icegoaliepaul/index/pnp/pcb/mobo/todo.txt

todo!

-decoupling on vacuum sensor stuff
