icegoaliepaul/index/pnp/cad/1.1.0/z-gantry-stepper-right.step

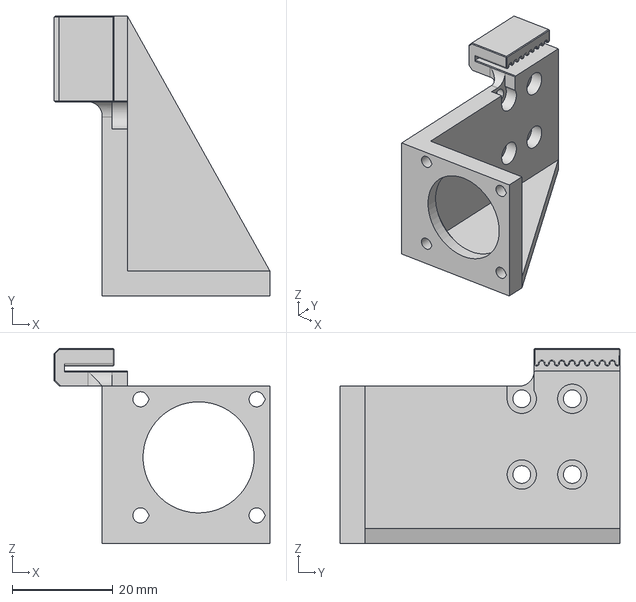
[picture p1: CAD file, 2020-12-14]
pnp/cad/1.1.0/z-gantry-stepper-right.step
42.7 x 55.5 x 38.7 mm
