icegoaliepaul/index/pnp/cad/1.1.0/STLs/y-gantry-right.stl

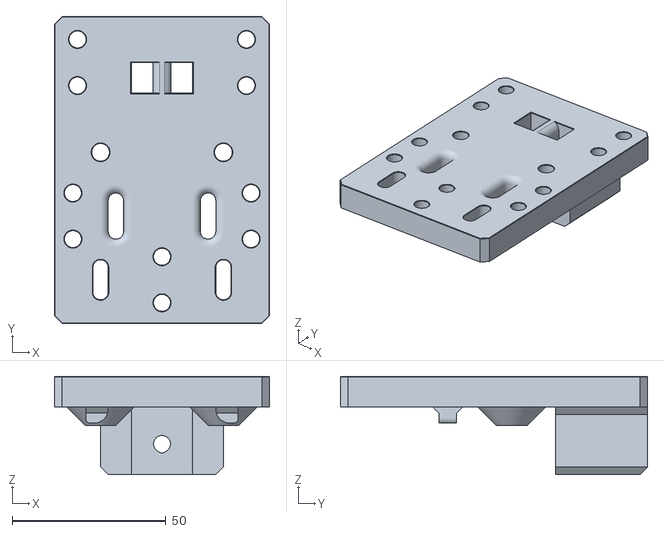
[picture p2: CAD file, 2020-11-08]
pnp/cad/1.1.0/STLs/y-gantry-right.stl
70.0 x 100.0 x 32.0
