icegoaliepaul/index/pnp/cad/1.1.0/z-gantry-stepper-left.step

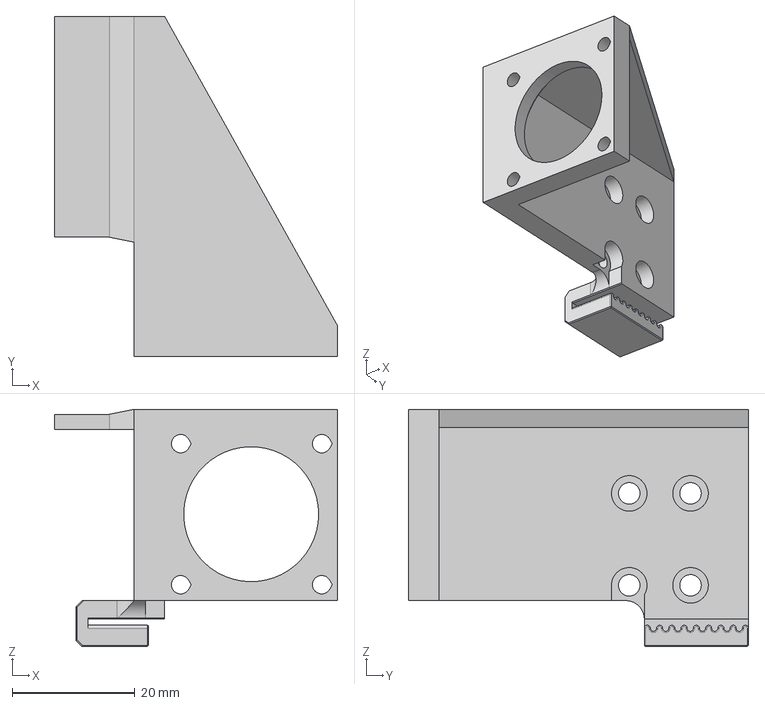
[picture p3: CAD file, 2020-12-14]
pnp/cad/1.1.0/z-gantry-stepper-left.step
46.2 x 55.5 x 38.7 mm
