icegoaliepaul/index/pnp/cad/1.1.0/x-limit-switch-actuator.step

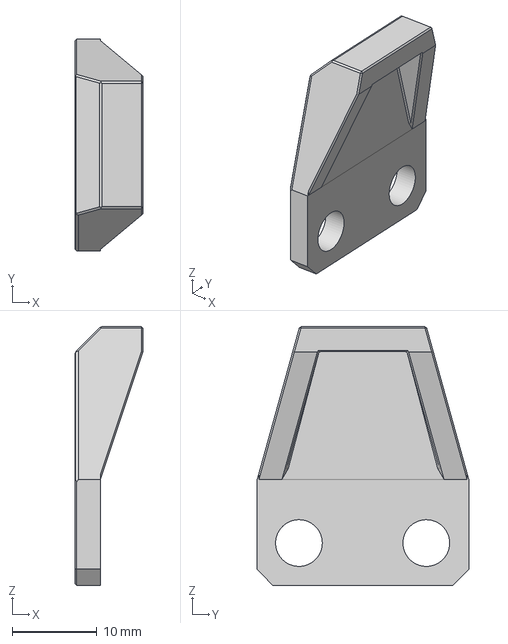
[picture p4: CAD file, 2020-11-16]
pnp/cad/1.1.0/x-limit-switch-actuator.step
8.00 x 24.9 x 30.5 mm
