icegoaliepaul/index/pnp/cad/1.1.0/Camera Holder.step

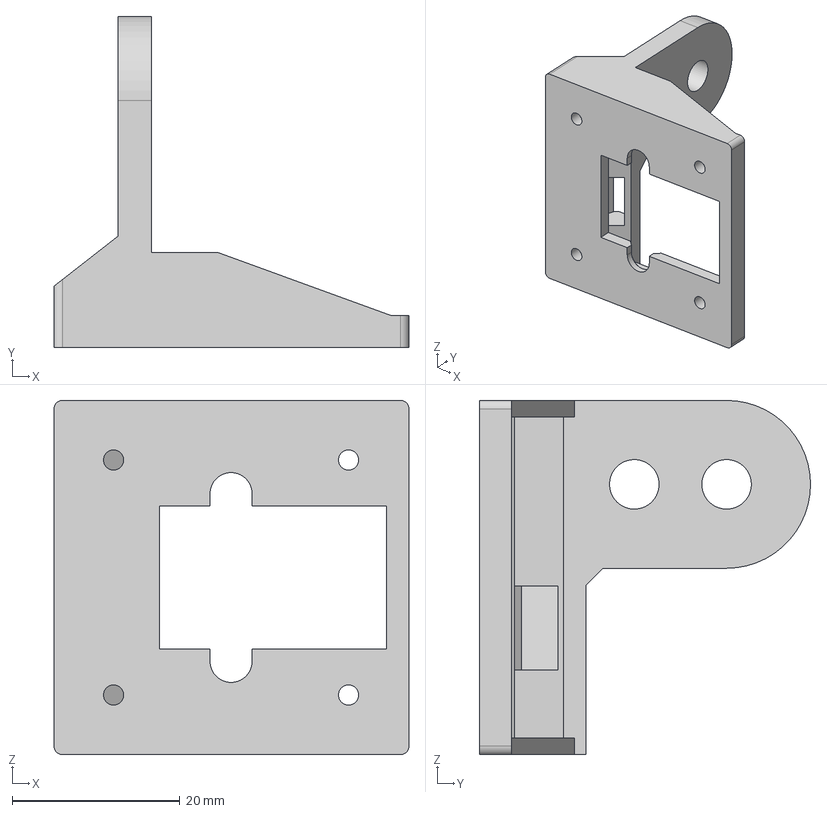
[picture p5: CAD file, 2020-11-13]
pnp/cad/1.1.0/Camera Holder.step
42.3 x 39.5 x 42.2 mm
