icegoaliepaul/index/pnp/cad/1.1.0/STLs/y-gantry-belt-standoff.stl

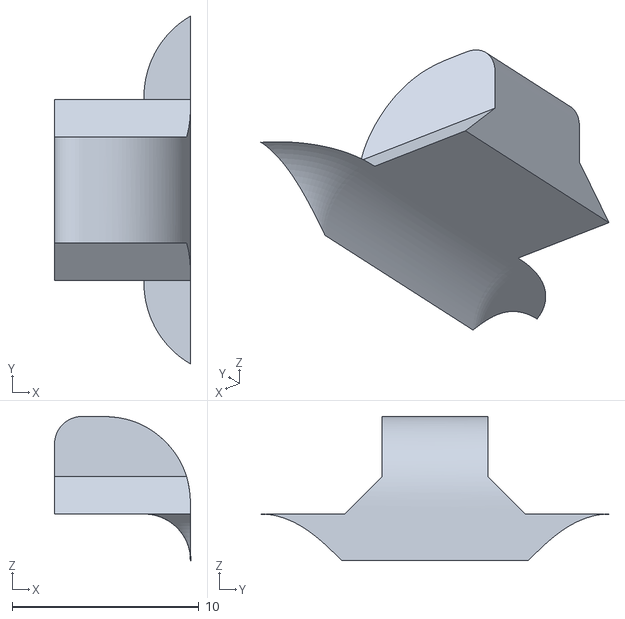
[picture p6: CAD file, 2020-11-08]
pnp/cad/1.1.0/STLs/y-gantry-belt-standoff.stl
7.30 x 18.7 x 7.74
