icegoaliepaul/index/(list of files, cad)

Other CAD files:
pnp/cad/1.1.0/STLs/y-gantry-left.stl
pnp/cad/1.1.0/Camera Holder.f3d
pnp/cad/1.1.0/STLs/Camera Holder.stl
pnp/cad/1.1.0/STLs/x-limit-switch-actuator.stl
pnp/cad/1.1.0/STLs/z-gantry-stepper-left.stl
pnp/cad/1.1.0/STLs/z-gantry-stepper-right.stl
pnp/cad/1.1.0/x-limit-switch-actuator.f3d
pnp/cad/1.1.0/z-gantry-stepper-left.f3d
pnp/cad/1.1.0/z-gantry-stepper-right.f3d
