icegoaliepaul/index/pnp/pcb/mobo/mobo.kicad_pcb

## KiCad design pnp/pcb/mobo/mobo.kicad_pcb (2020-12-23)

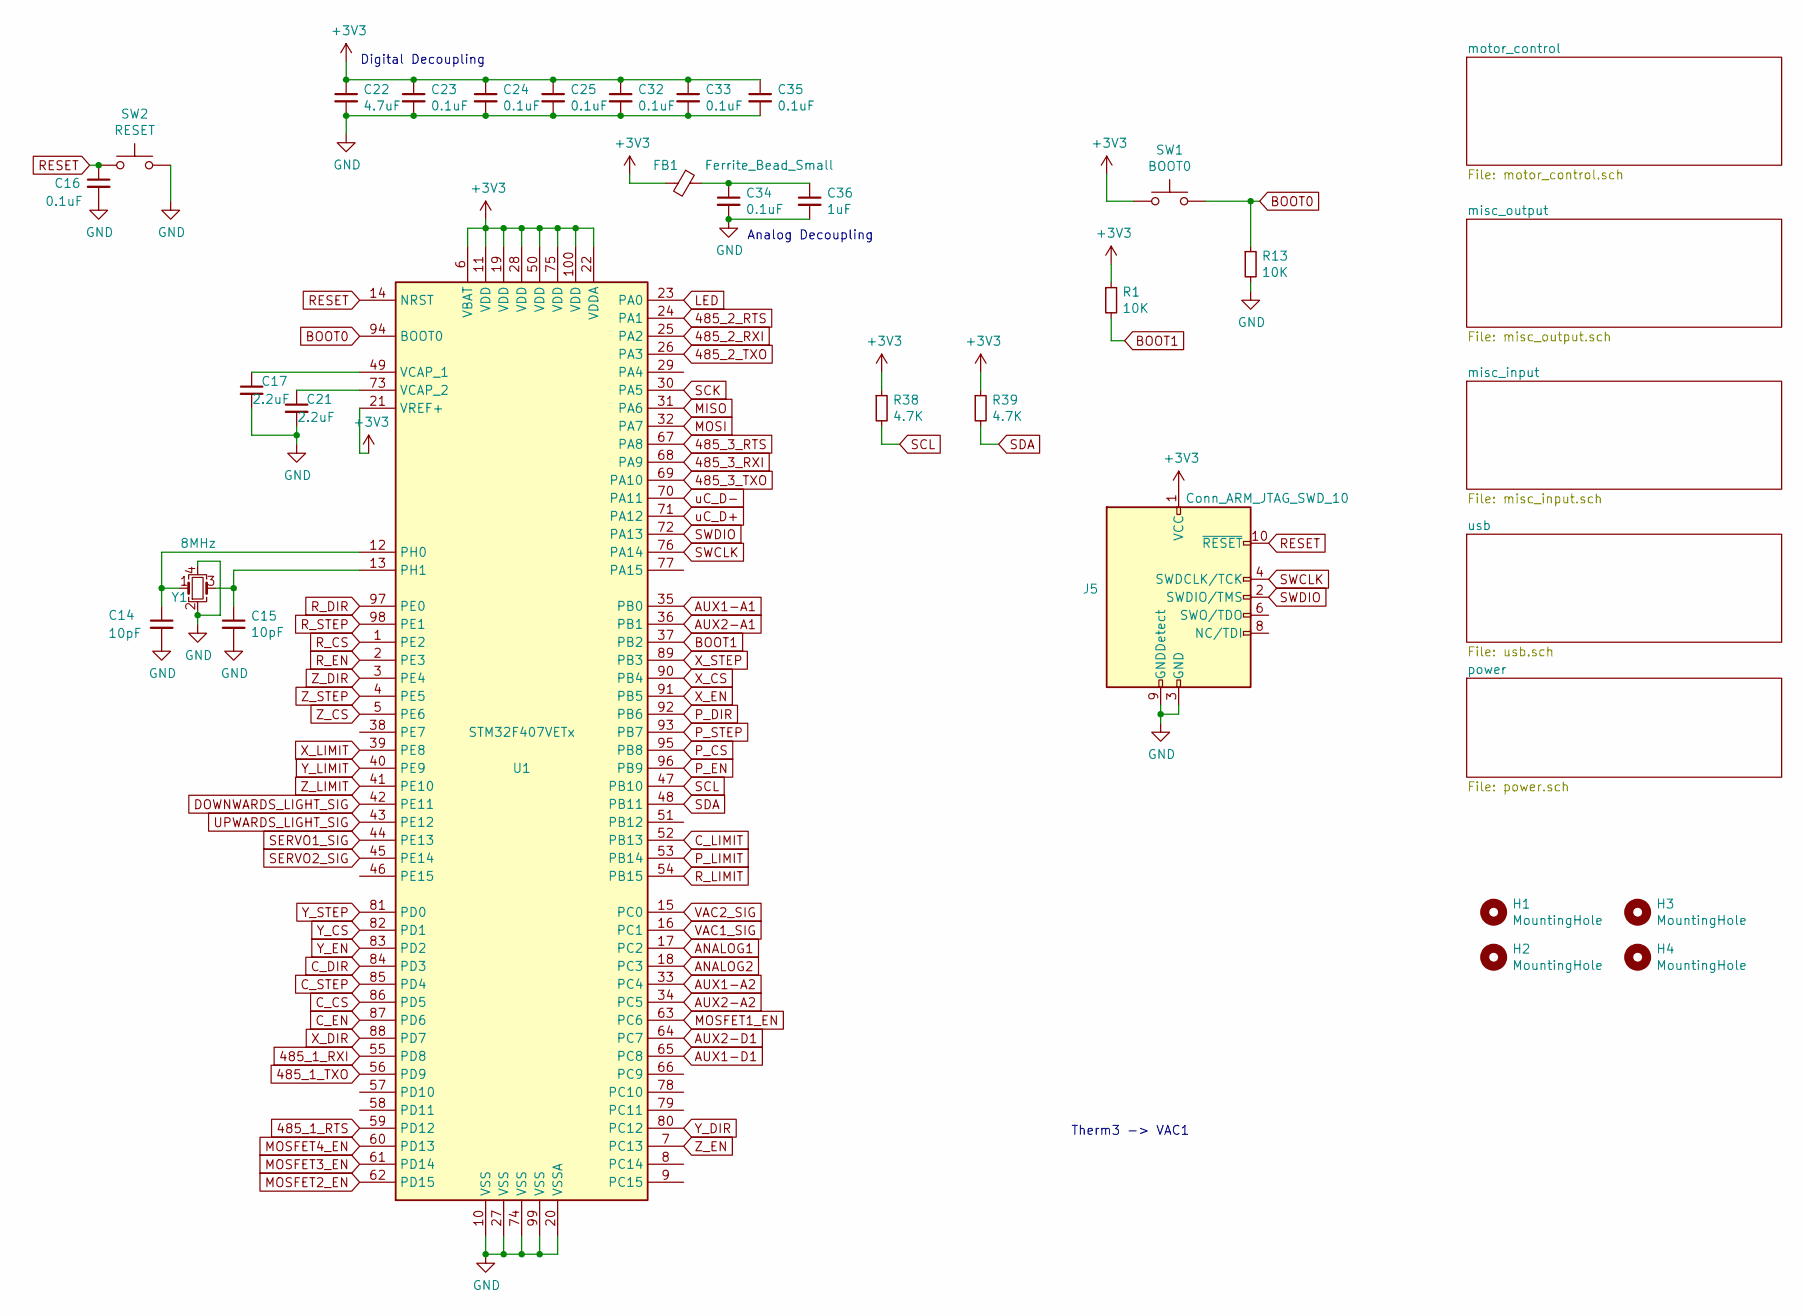
[picture p7: schematic mobo.sch]

Parts:
C14, C15: 10pF; C_0805_2012Metric_Pad1.15x1.40mm_HandSolder
C16, C23, C24, C25, C32, C33, C34, C35: 0.1uF; C_0805_2012Metric_Pad1.15x1.40mm_HandSolder
C17, C21: 2.2uF; C_0805_2012Metric_Pad1.15x1.40mm_HandSolder
C22: 4.7uF; C_0805_2012Metric_Pad1.15x1.40mm_HandSolder
C36: 1uF; C_0805_2012Metric_Pad1.15x1.40mm_HandSolder
FB1: Ferrite_Bead_Small; L_0805_2012Metric_Pad1.15x1.40mm_HandSolder
H1, H2, H3, H4: MountingHole; MountingHole_3.2mm_M3_DIN965_Pad
J5: Conn_ARM_JTAG_SWD_10; PinHeader_2x05_P1.27mm_Vertical_SMD
R1, R13: 10K; R_0805_2012Metric_Pad1.15x1.40mm_HandSolder
R38, R39: 4.7K; R_0805_2012Metric_Pad1.15x1.40mm_HandSolder
SW1: BOOT0; SW_SPST_B3S-1000
SW2: RESET; SW_SPST_B3S-1000
U1: STM32F407VETx; LQFP-100_14x14mm_P0.5mm
Y1: 8MHz; Crystal_SMD_3225-4Pin_3.2x2.5mm

Connections:
485_1_RTS: U1.59 (PD12); also elsewhere on the board
485_1_RXI: U1.55 (PD8); also elsewhere on the board
485_1_TXO: U1.56 (PD9); also elsewhere on the board
485_2_RTS: U1.24 (PA1); also elsewhere on the board
485_2_RXI: U1.25 (PA2); also elsewhere on the board
485_2_TXO: U1.26 (PA3); also elsewhere on the board
485_3_RTS: U1.67 (PA8); also elsewhere on the board
485_3_RXI: U1.68 (PA9); also elsewhere on the board
485_3_TXO: U1.69 (PA10); also elsewhere on the board
ANALOG1: U1.17 (PC2)
ANALOG2: U1.18 (PC3)
AUX1-A1: U1.35 (PB0); also elsewhere on the board
AUX1-A2: U1.33 (PC4); also elsewhere on the board
AUX1-D1: U1.65 (PC8); also elsewhere on the board
AUX2-A1: U1.36 (PB1); also elsewhere on the board
AUX2-A2: U1.34 (PC5); also elsewhere on the board
AUX2-D1: U1.64 (PC7); also elsewhere on the board
BOOT0: R13.1, SW1.2, U1.94 (BOOT0)
BOOT1: R1.2, U1.37 (PB2)
C_CS: U1.86 (PD5); also elsewhere on the board
C_DIR: U1.84 (PD3); also elsewhere on the board
C_EN: U1.87 (PD6); also elsewhere on the board
C_LIMIT: U1.52 (PB13); also elsewhere on the board
C_STEP: U1.85 (PD4); also elsewhere on the board
DOWNWARDS_LIGHT_SIG: U1.42 (PE11); also elsewhere on the board
GND: C14.2, C15.2, C16.2, C17.2, C21.2, C22.2, C23.2, C24.2, C25.2, C32.2, C33.2, C34.2, C35.2, C36.2, J5.3 (GND), J5.5 (GND), J5.9 (GNDDetect), R13.2, SW2.2, U1.10 (VSS), U1.20 (VSSA), U1.27 (VSS), U1.74 (VSS), U1.99 (VSS), Y1.2, Y1.4; also elsewhere on the board
LED: U1.23 (PA0); also elsewhere on the board
MISO: U1.31 (PA6); also elsewhere on the board
MOSFET1_EN: U1.63 (PC6); also elsewhere on the board
MOSFET2_EN: U1.62 (PD15); also elsewhere on the board
MOSFET3_EN: U1.61 (PD14); also elsewhere on the board
MOSFET4_EN: U1.60 (PD13); also elsewhere on the board
MOSI: U1.32 (PA7); also elsewhere on the board
unnamed: C14.1, U1.12 (PH0), Y1.1
unnamed: C15.1, U1.13 (PH1), Y1.3
unnamed: C17.1, U1.49 (VCAP_1)
unnamed: C21.1, U1.73 (VCAP_2)
unnamed: C34.1, C36.1, FB1.1
P_CS: U1.95 (PB8); also elsewhere on the board
P_DIR: U1.92 (PB6); also elsewhere on the board
P_EN: U1.96 (PB9); also elsewhere on the board
P_LIMIT: U1.53 (PB14); also elsewhere on the board
P_STEP: U1.93 (PB7); also elsewhere on the board
RESET: C16.1, J5.10 (~RESET~), SW2.1, U1.14 (NRST)
R_CS: U1.1 (PE2); also elsewhere on the board
R_DIR: U1.97 (PE0); also elsewhere on the board
R_EN: U1.2 (PE3); also elsewhere on the board
R_LIMIT: U1.54 (PB15); also elsewhere on the board
R_STEP: U1.98 (PE1); also elsewhere on the board
SCK: U1.30 (PA5); also elsewhere on the board
SCL: R38.2, U1.47 (PB10); also elsewhere on the board
SDA: R39.2, U1.48 (PB11); also elsewhere on the board
SERVO1_SIG: U1.44 (PE13); also elsewhere on the board
SERVO2_SIG: U1.45 (PE14); also elsewhere on the board
SWCLK: J5.4 (SWDCLK/TCK), U1.76 (PA14)
SWDIO: J5.2 (SWDIO/TMS), U1.72 (PA13)
UPWARDS_LIGHT_SIG: U1.43 (PE12); also elsewhere on the board
VAC1_SIG: U1.16 (PC1); also elsewhere on the board
VAC2_SIG: U1.15 (PC0); also elsewhere on the board
X_CS: U1.90 (PB4); also elsewhere on the board
X_DIR: U1.88 (PD7); also elsewhere on the board
X_EN: U1.91 (PB5); also elsewhere on the board
X_LIMIT: U1.39 (PE8); also elsewhere on the board
X_STEP: U1.89 (PB3); also elsewhere on the board
Y_CS: U1.82 (PD1); also elsewhere on the board
Y_DIR: U1.80 (PC12); also elsewhere on the board
Y_EN: U1.83 (PD2); also elsewhere on the board
Y_LIMIT: U1.40 (PE9); also elsewhere on the board
Y_STEP: U1.81 (PD0); also elsewhere on the board
Z_CS: U1.5 (PE6); also elsewhere on the board
Z_DIR: U1.3 (PE4); also elsewhere on the board
Z_EN: U1.7 (PC13); also elsewhere on the board
Z_LIMIT: U1.41 (PE10); also elsewhere on the board
Z_STEP: U1.4 (PE5); also elsewhere on the board
uC_D+: U1.71 (PA12); also elsewhere on the board
uC_D-: U1.70 (PA11); also elsewhere on the board

Notes on the sheet:
Therm3 -> VAC1
Analog Decoupling
Digital Decoupling

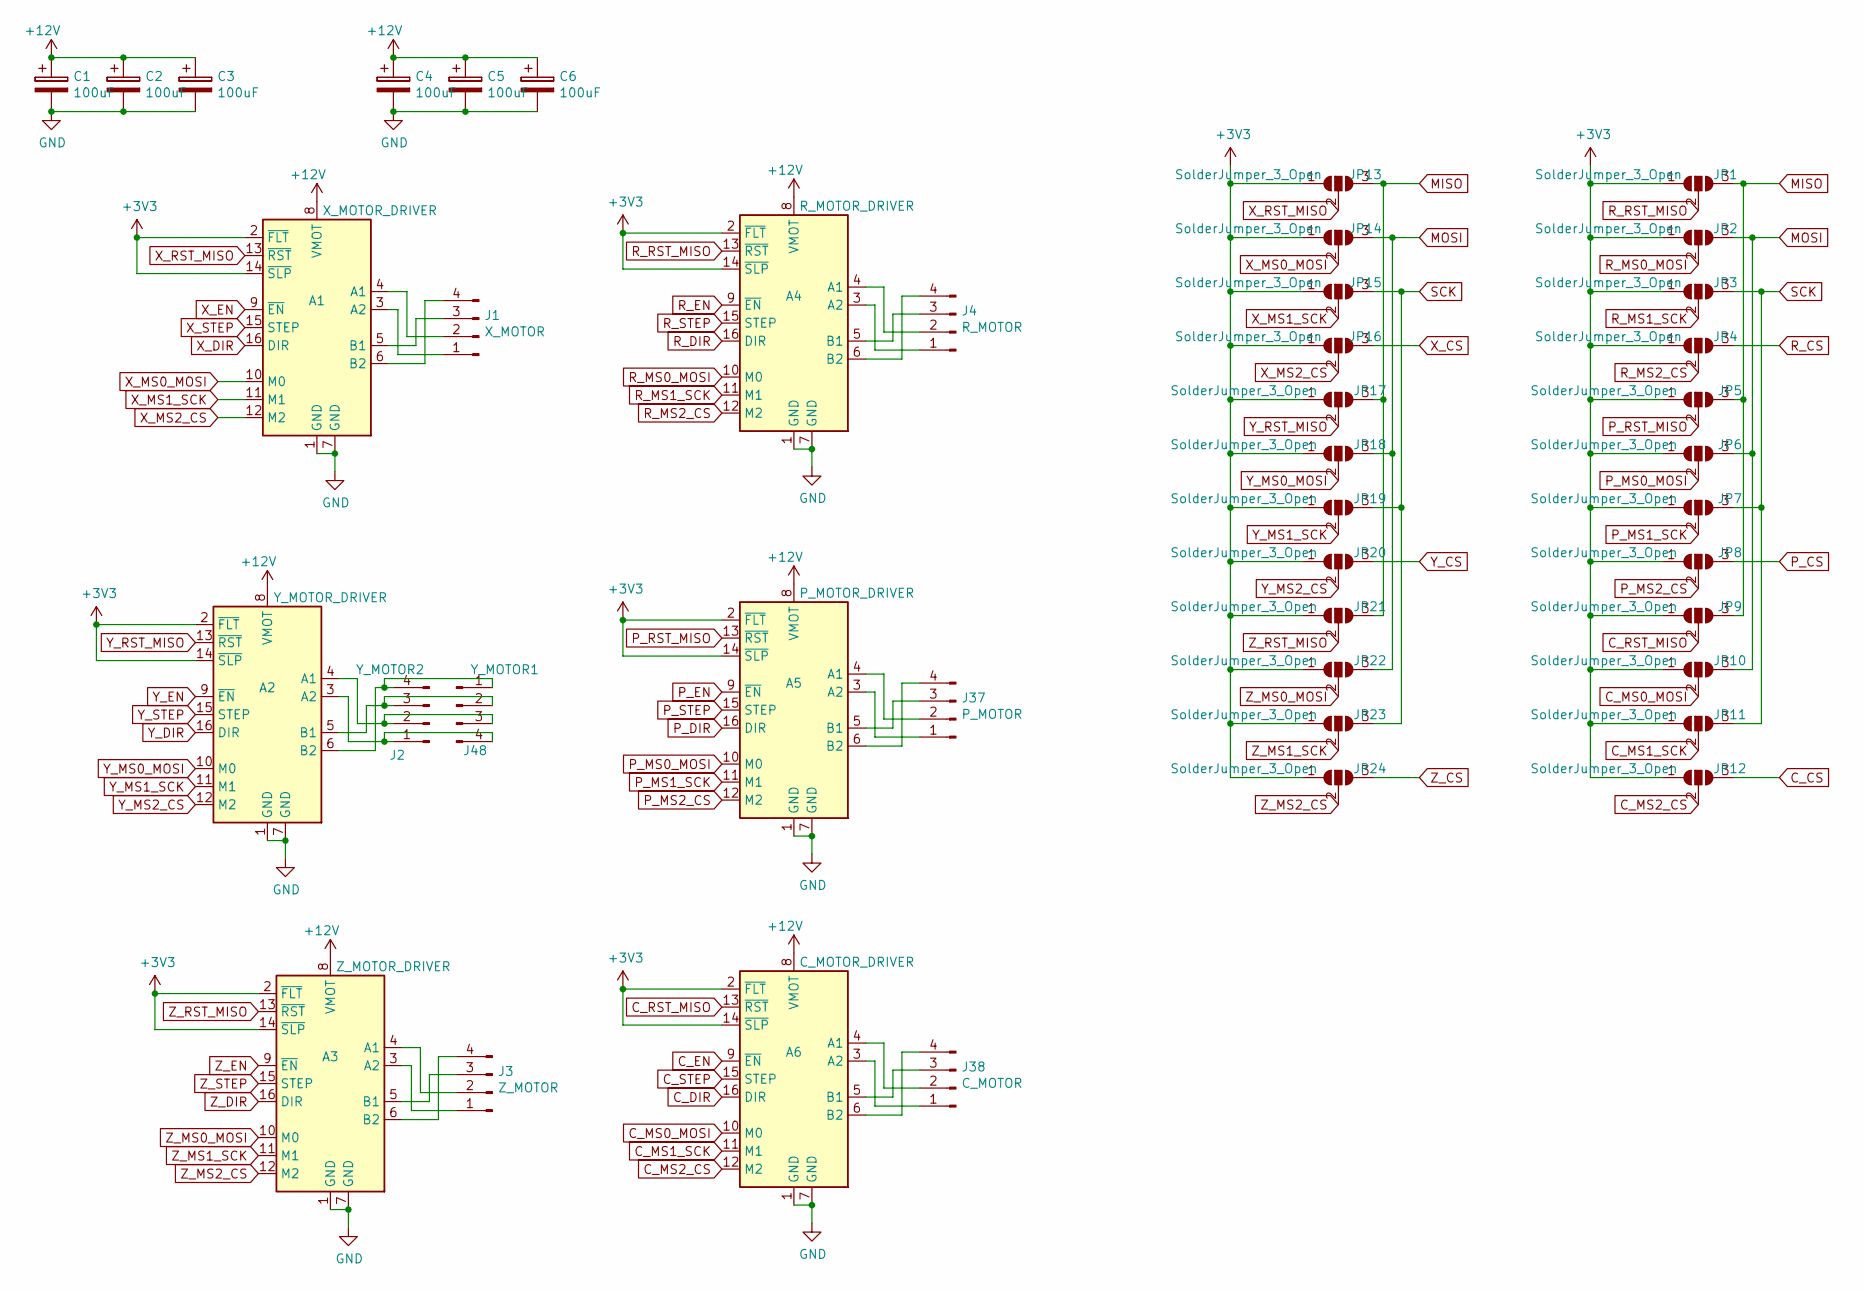
[picture p8: schematic motor_control.sch]

Parts:
A1: X_MOTOR_DRIVER; Pololu_Breakout-16_15.2x20.3mm
A2: Y_MOTOR_DRIVER; Pololu_Breakout-16_15.2x20.3mm
A3: Z_MOTOR_DRIVER; Pololu_Breakout-16_15.2x20.3mm
A4: R_MOTOR_DRIVER; Pololu_Breakout-16_15.2x20.3mm
A5: P_MOTOR_DRIVER; Pololu_Breakout-16_15.2x20.3mm
A6: C_MOTOR_DRIVER; Pololu_Breakout-16_15.2x20.3mm
C1, C2, C3, C4, C5, C6: 100uF; CP_Elec_6.3x7.7
J1: X_MOTOR; JST_XH_B04B-XH-A_1x04_P2.50mm_Vertical
J2: Y_MOTOR1; JST_XH_B04B-XH-A_1x04_P2.50mm_Vertical
J3: Z_MOTOR; JST_XH_B04B-XH-A_1x04_P2.50mm_Vertical
J4: R_MOTOR; JST_XH_B04B-XH-A_1x04_P2.50mm_Vertical
J37: P_MOTOR; JST_XH_B04B-XH-A_1x04_P2.50mm_Vertical
J38: C_MOTOR; JST_XH_B04B-XH-A_1x04_P2.50mm_Vertical
J48: Y_MOTOR2; JST_XH_B04B-XH-A_1x04_P2.50mm_Vertical
JP1, JP2, JP3, JP4, JP5, JP6, JP7, JP8, JP9, JP10, JP11, JP12, JP13, JP14, JP15, JP16, JP17, JP18, JP19, JP20, JP21, JP22, JP23, JP24: SolderJumper_3_Open; PinSocket_1x03_P2.54mm_Vertical

Connections:
+12V: A1.8 (VMOT), A2.8 (VMOT), A3.8 (VMOT), A4.8 (VMOT), A5.8 (VMOT), A6.8 (VMOT), C1.1, C2.1, C3.1, C4.1, C5.1, C6.1; also elsewhere on the board
C_CS: JP12.3 (B); also elsewhere on the board
C_DIR: A6.16 (DIR); also elsewhere on the board
C_EN: A6.9 (~EN); also elsewhere on the board
C_MS0_MOSI: A6.10 (M0), JP10.2 (C)
C_MS1_SCK: A6.11 (M1), JP11.2 (C)
C_MS2_CS: A6.12 (M2), JP12.2 (C)
C_RST_MISO: A6.13 (~RST), JP9.2 (C)
C_STEP: A6.15 (STEP); also elsewhere on the board
GND: A1.1 (GND), A1.7 (GND), A2.1 (GND), A2.7 (GND), A3.1 (GND), A3.7 (GND), A4.1 (GND), A4.7 (GND), A5.1 (GND), A5.7 (GND), A6.1 (GND), A6.7 (GND), C1.2, C2.2, C3.2, C4.2, C5.2, C6.2; also elsewhere on the board
MISO: JP1.3 (B), JP5.3 (B), JP9.3 (B), JP13.3 (B), JP17.3 (B), JP21.3 (B); also elsewhere on the board
MOSI: JP2.3 (B), JP6.3 (B), JP10.3 (B), JP14.3 (B), JP18.3 (B), JP22.3 (B); also elsewhere on the board
unnamed: A1.3 (A2), J1.1
unnamed: A1.4 (A1), J1.2
unnamed: A1.5 (B1), J1.3
unnamed: A1.6 (B2), J1.4
unnamed: A2.3 (A2), J2.1, J48.4
unnamed: A2.4 (A1), J2.2, J48.3
unnamed: A2.5 (B1), J2.3, J48.2
unnamed: A2.6 (B2), J2.4, J48.1
unnamed: A3.3 (A2), J3.1
unnamed: A3.4 (A1), J3.2
unnamed: A3.5 (B1), J3.3
unnamed: A3.6 (B2), J3.4
unnamed: A4.3 (A2), J4.1
unnamed: A4.4 (A1), J4.2
unnamed: A4.5 (B1), J4.3
unnamed: A4.6 (B2), J4.4
unnamed: A5.3 (A2), J37.1
unnamed: A5.4 (A1), J37.2
unnamed: A5.5 (B1), J37.3
unnamed: A5.6 (B2), J37.4
unnamed: A6.3 (A2), J38.1
unnamed: A6.4 (A1), J38.2
unnamed: A6.5 (B1), J38.3
unnamed: A6.6 (B2), J38.4
P_CS: JP8.3 (B); also elsewhere on the board
P_DIR: A5.16 (DIR); also elsewhere on the board
P_EN: A5.9 (~EN); also elsewhere on the board
P_MS0_MOSI: A5.10 (M0), JP6.2 (C)
P_MS1_SCK: A5.11 (M1), JP7.2 (C)
P_MS2_CS: A5.12 (M2), JP8.2 (C)
P_RST_MISO: A5.13 (~RST), JP5.2 (C)
P_STEP: A5.15 (STEP); also elsewhere on the board
R_CS: JP4.3 (B); also elsewhere on the board
R_DIR: A4.16 (DIR); also elsewhere on the board
R_EN: A4.9 (~EN); also elsewhere on the board
R_MS0_MOSI: A4.10 (M0), JP2.2 (C)
R_MS1_SCK: A4.11 (M1), JP3.2 (C)
R_MS2_CS: A4.12 (M2), JP4.2 (C)
R_RST_MISO: A4.13 (~RST), JP1.2 (C)
R_STEP: A4.15 (STEP); also elsewhere on the board
SCK: JP3.3 (B), JP7.3 (B), JP11.3 (B), JP15.3 (B), JP19.3 (B), JP23.3 (B); also elsewhere on the board
X_CS: JP16.3 (B); also elsewhere on the board
X_DIR: A1.16 (DIR); also elsewhere on the board
X_EN: A1.9 (~EN); also elsewhere on the board
X_MS0_MOSI: A1.10 (M0), JP14.2 (C)
X_MS1_SCK: A1.11 (M1), JP15.2 (C)
X_MS2_CS: A1.12 (M2), JP16.2 (C)
X_RST_MISO: A1.13 (~RST), JP13.2 (C)
X_STEP: A1.15 (STEP); also elsewhere on the board
Y_CS: JP20.3 (B); also elsewhere on the board
Y_DIR: A2.16 (DIR); also elsewhere on the board
Y_EN: A2.9 (~EN); also elsewhere on the board
Y_MS0_MOSI: A2.10 (M0), JP18.2 (C)
Y_MS1_SCK: A2.11 (M1), JP19.2 (C)
Y_MS2_CS: A2.12 (M2), JP20.2 (C)
Y_RST_MISO: A2.13 (~RST), JP17.2 (C)
Y_STEP: A2.15 (STEP); also elsewhere on the board
Z_CS: JP24.3 (B); also elsewhere on the board
Z_DIR: A3.16 (DIR); also elsewhere on the board
Z_EN: A3.9 (~EN); also elsewhere on the board
Z_MS0_MOSI: A3.10 (M0), JP22.2 (C)
Z_MS1_SCK: A3.11 (M1), JP23.2 (C)
Z_MS2_CS: A3.12 (M2), JP24.2 (C)
Z_RST_MISO: A3.13 (~RST), JP21.2 (C)
Z_STEP: A3.15 (STEP); also elsewhere on the board

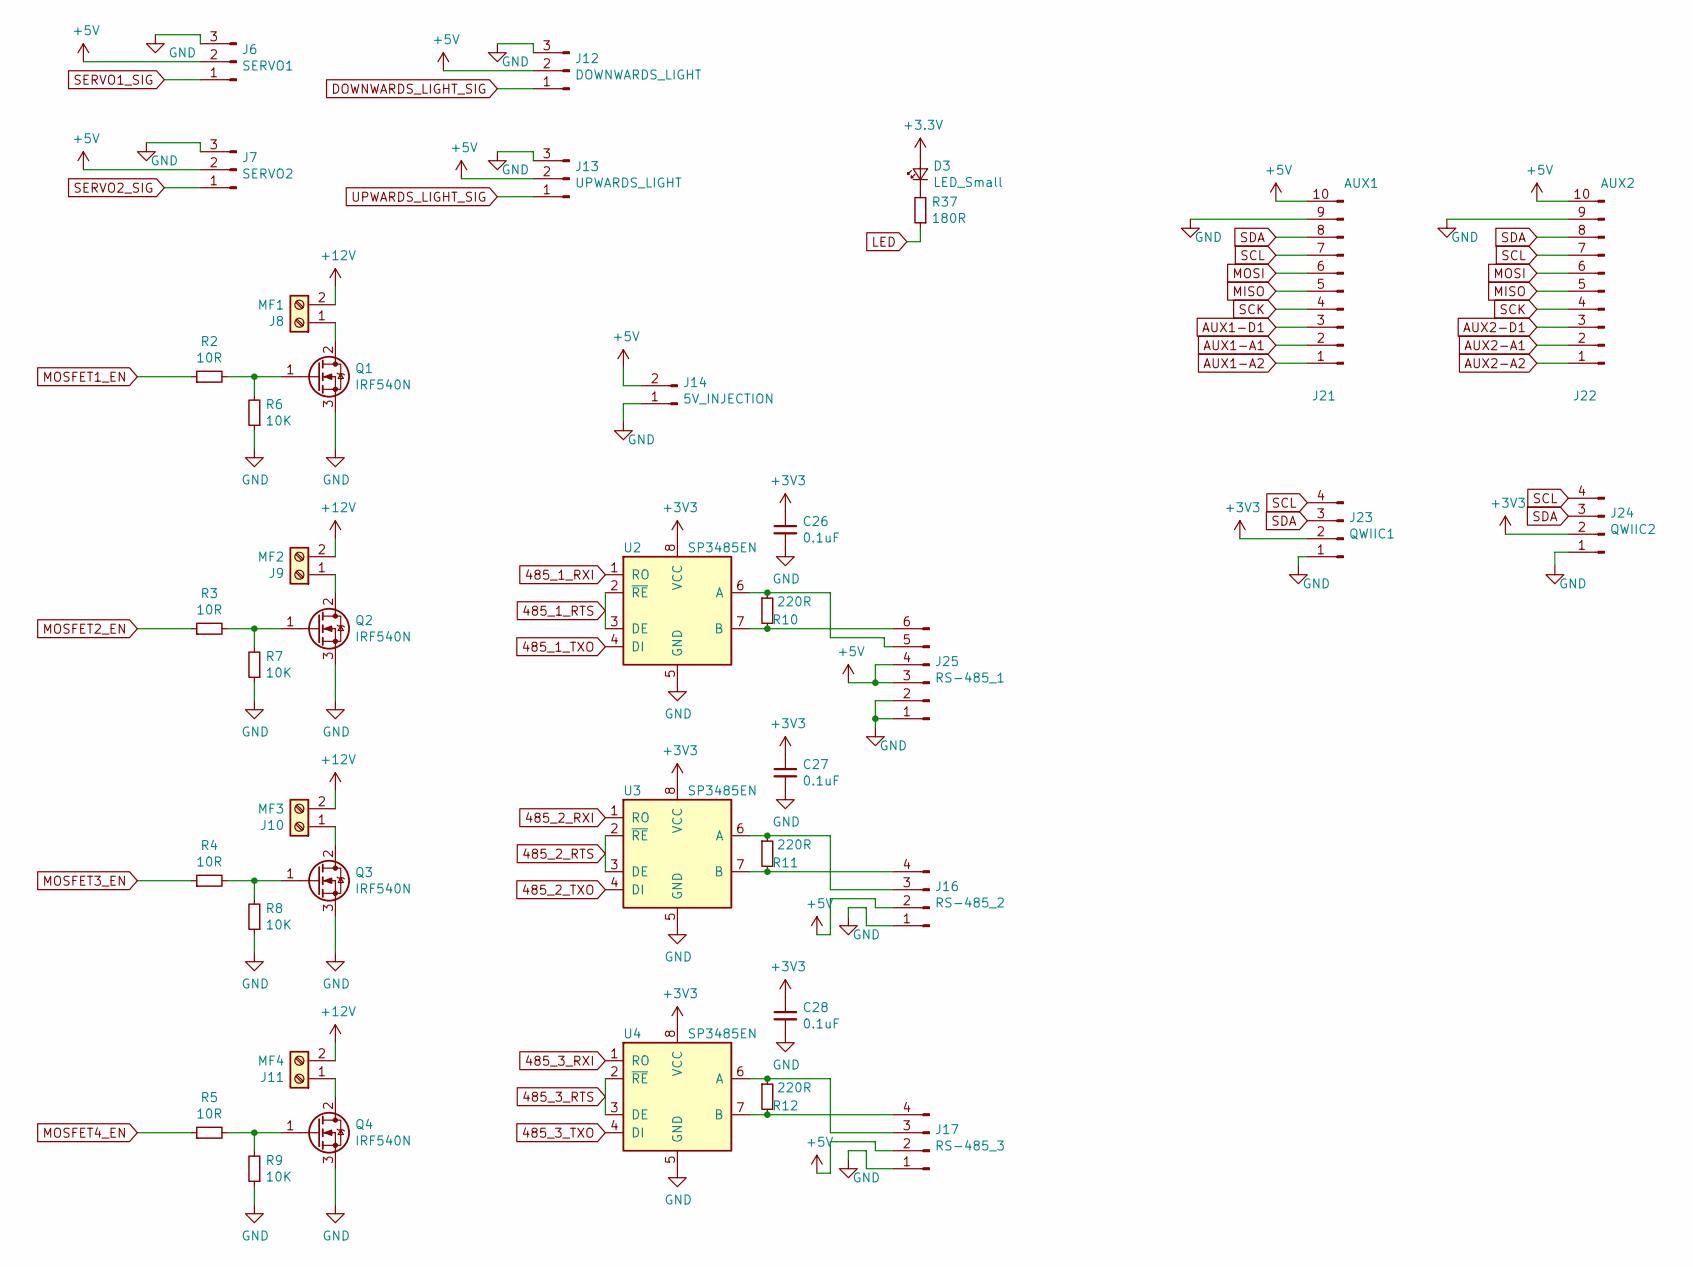
[picture p9: schematic misc_output.sch]

Parts:
C26, C27, C28: 0.1uF; C_0805_2012Metric_Pad1.15x1.40mm_HandSolder
D3: LED_Small; LED_0805_2012Metric
J6: SERVO1; JST_XH_B03B-XH-A_1x03_P2.50mm_Vertical
J7: SERVO2; JST_XH_B03B-XH-A_1x03_P2.50mm_Vertical
J8: MF1; JST_XH_B02B-XH-A_1x02_P2.50mm_Vertical
J9: MF2; JST_XH_B02B-XH-A_1x02_P2.50mm_Vertical
J10: MF3; JST_XH_B02B-XH-A_1x02_P2.50mm_Vertical
J11: MF4; JST_XH_B02B-XH-A_1x02_P2.50mm_Vertical
J12: DOWNWARDS_LIGHT; JST_XH_B03B-XH-A_1x03_P2.50mm_Vertical
J13: UPWARDS_LIGHT; JST_XH_B03B-XH-A_1x03_P2.50mm_Vertical
J14: 5V_INJECTION; JST_XH_B02B-XH-A_1x02_P2.50mm_Vertical
J16: RS-485_2; JST_XH_B04B-XH-A_1x04_P2.50mm_Vertical
J17: RS-485_3; JST_XH_B04B-XH-A_1x04_P2.50mm_Vertical
J21: AUX1; IDC-Header_2x05_P2.54mm_Vertical
J22: AUX2; IDC-Header_2x05_P2.54mm_Vertical
J23: QWIIC1; JST_SH_BM04B-SRSS-TB_1x04-1MP_P1.00mm_Vertical
J24: QWIIC2; JST_SH_BM04B-SRSS-TB_1x04-1MP_P1.00mm_Vertical
J25: RS-485_1; IDC-Header_2x03_P2.54mm_Vertical
Q1, Q2, Q3, Q4: IRF540N; TO-252-2
R2, R3, R4, R5: 10R; R_0805_2012Metric_Pad1.15x1.40mm_HandSolder
R6, R7, R8, R9: 10K; R_0805_2012Metric_Pad1.15x1.40mm_HandSolder
R10, R11, R12: 220R; R_0805_2012Metric_Pad1.15x1.40mm_HandSolder
R37: 180R; R_0805_2012Metric_Pad1.15x1.40mm_HandSolder
U2, U3, U4: SP3485EN; SOIC-8_3.9x4.9mm_P1.27mm

Connections:
485_1_RTS: U2.2 (~RE~), U2.3 (DE); also elsewhere on the board
485_1_RXI: U2.1 (RO); also elsewhere on the board
485_1_TXO: U2.4 (DI); also elsewhere on the board
485_2_RTS: U3.2 (~RE~), U3.3 (DE); also elsewhere on the board
485_2_RXI: U3.1 (RO); also elsewhere on the board
485_2_TXO: U3.4 (DI); also elsewhere on the board
485_3_RTS: U4.2 (~RE~), U4.3 (DE); also elsewhere on the board
485_3_RXI: U4.1 (RO); also elsewhere on the board
485_3_TXO: U4.4 (DI); also elsewhere on the board
+5V: J6.2, J7.2, J12.2, J13.2, J14.2, J16.2, J17.2, J21.10, J22.10, J25.3, J25.4; also elsewhere on the board
+12V: J8.2, J9.2, J10.2, J11.2; also elsewhere on the board
AUX1-A1: J21.2; also elsewhere on the board
AUX1-A2: J21.1; also elsewhere on the board
AUX1-D1: J21.3; also elsewhere on the board
AUX2-A1: J22.2; also elsewhere on the board
AUX2-A2: J22.1; also elsewhere on the board
AUX2-D1: J22.3; also elsewhere on the board
DOWNWARDS_LIGHT_SIG: J12.1; also elsewhere on the board
GND: C26.2, C27.2, C28.2, J6.3, J7.3, J12.3, J13.3, J14.1, J16.1, J17.1, J21.9, J22.9, J23.1, J24.1, J25.1, J25.2, Q1.3 (S), Q2.3 (S), Q3.3 (S), Q4.3 (S), R6.1, R7.1, R8.1, R9.1, U2.5 (GND), U3.5 (GND), U4.5 (GND); also elsewhere on the board
LED: R37.1; also elsewhere on the board
MISO: J21.5, J22.5; also elsewhere on the board
MOSFET1_EN: R2.1; also elsewhere on the board
MOSFET2_EN: R3.1; also elsewhere on the board
MOSFET3_EN: R4.1; also elsewhere on the board
MOSFET4_EN: R5.1; also elsewhere on the board
MOSI: J21.6, J22.6; also elsewhere on the board
unnamed: D3.1 (K), R37.2
unnamed: J8.1, Q1.2 (D)
unnamed: J9.1, Q2.2 (D)
unnamed: J10.1, Q3.2 (D)
unnamed: J11.1, Q4.2 (D)
unnamed: J16.3, R11.1, U3.6 (A)
unnamed: J16.4, R11.2, U3.7 (B)
unnamed: J17.3, R12.1, U4.6 (A)
unnamed: J17.4, R12.2, U4.7 (B)
unnamed: J25.5, R10.1, U2.6 (A)
unnamed: J25.6, R10.2, U2.7 (B)
unnamed: Q1.1 (G), R2.2, R6.2
unnamed: Q2.1 (G), R3.2, R7.2
unnamed: Q3.1 (G), R4.2, R8.2
unnamed: Q4.1 (G), R5.2, R9.2
SCK: J21.4, J22.4; also elsewhere on the board
SCL: J21.7, J22.7, J23.4, J24.4; also elsewhere on the board
SDA: J21.8, J22.8, J23.3, J24.3; also elsewhere on the board
SERVO1_SIG: J6.1; also elsewhere on the board
SERVO2_SIG: J7.1; also elsewhere on the board
UPWARDS_LIGHT_SIG: J13.1; also elsewhere on the board

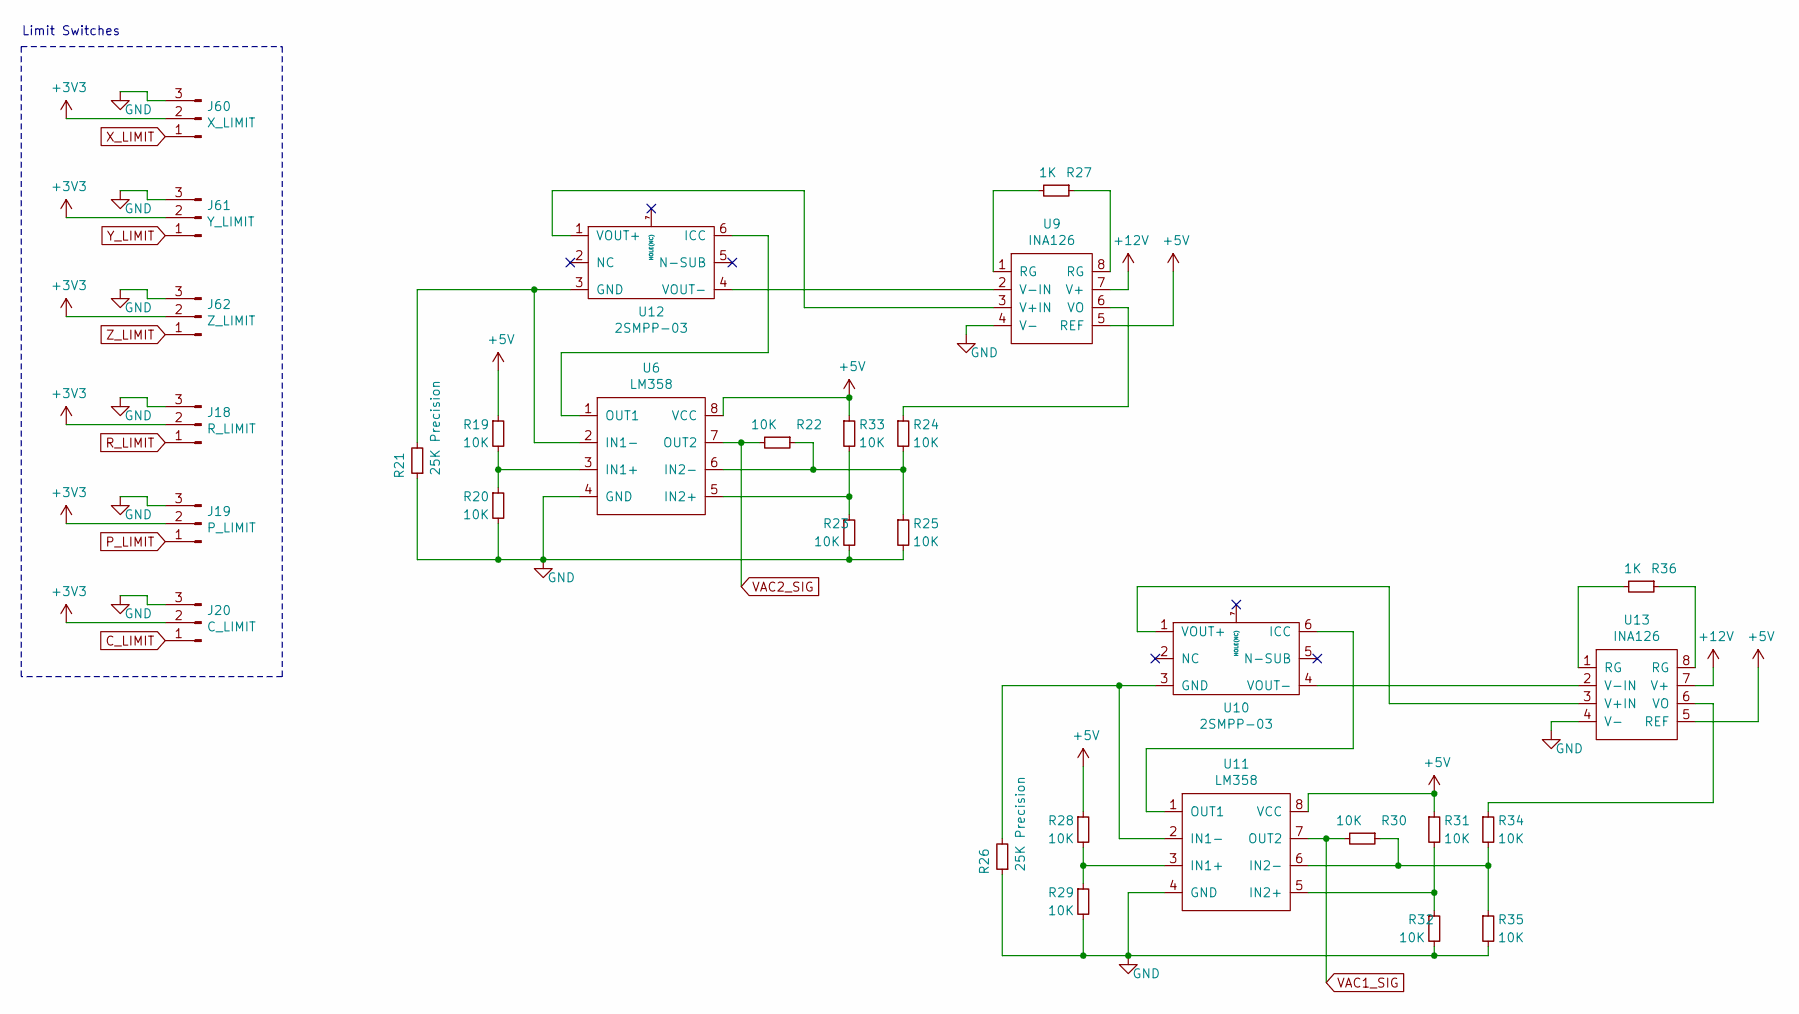
[picture p10: schematic misc_input.sch]

Parts:
J18: R_LIMIT; JST_XH_B03B-XH-A_1x03_P2.50mm_Vertical
J19: P_LIMIT; JST_XH_B03B-XH-A_1x03_P2.50mm_Vertical
J20: C_LIMIT; JST_XH_B03B-XH-A_1x03_P2.50mm_Vertical
J60: X_LIMIT; JST_XH_B03B-XH-A_1x03_P2.50mm_Vertical
J61: Y_LIMIT; JST_XH_B03B-XH-A_1x03_P2.50mm_Vertical
J62: Z_LIMIT; JST_XH_B03B-XH-A_1x03_P2.50mm_Vertical
R19, R20, R22, R23, R24, R25, R28, R29, R30, R31, R32, R33, R34, R35: 10K; R_0805_2012Metric_Pad1.15x1.40mm_HandSolder
R21, R26: 25K Precision; R_0805_2012Metric_Pad1.15x1.40mm_HandSolder
R27, R36: 1K; R_0805_2012Metric_Pad1.15x1.40mm_HandSolder
U6, U11: LM358; SOP-8_3.9x4.9mm_P1.27mm
U9, U13: INA126; SOIC-8-1EP_3.9x4.9mm_P1.27mm_EP2.29x3mm
U10, U12: 2SMPP-03

Connections:
+5V: R19.1, R28.1, R31.1, R33.1, U6.8 (VCC), U9.5 (REF), U11.8 (VCC), U13.5 (REF); also elsewhere on the board
+12V: U9.7 (V+), U13.7 (V+); also elsewhere on the board
C_LIMIT: J20.1; also elsewhere on the board
GND: J18.3, J19.3, J20.3, J60.3, J61.3, J62.3, R20.2, R21.1, R23.2, R25.2, R26.1, R29.2, R32.2, R35.2, U6.4 (GND), U9.4 (V-), U11.4 (GND), U13.4 (V-); also elsewhere on the board
unnamed: R19.2, R20.1, U6.3 (IN1+)
unnamed: R21.2, U6.2 (IN1-), U12.3 (GND)
unnamed: R22.1, R24.2, R25.1, U6.6 (IN2-)
unnamed: R23.1, R33.2, U6.5 (IN2+)
unnamed: R24.1, U9.6 (VO)
unnamed: R26.2, U10.3 (GND), U11.2 (IN1-)
unnamed: R27.1, U9.8 (RG)
unnamed: R27.2, U9.1 (RG)
unnamed: R28.2, R29.1, U11.3 (IN1+)
unnamed: R30.1, R34.2, R35.1, U11.6 (IN2-)
unnamed: R31.2, R32.1, U11.5 (IN2+)
unnamed: R34.1, U13.6 (VO)
unnamed: R36.1, U13.8 (RG)
unnamed: R36.2, U13.1 (RG)
unnamed: U10.1 (VOUT+), U13.3 (V+IN)
unnamed: U10.4 (VOUT-), U13.2 (V-IN)
unnamed: U10.6 (ICC), U11.1 (OUT1)
unnamed: U9.3 (V+IN), U12.1 (VOUT+)
unnamed: U9.2 (V-IN), U12.4 (VOUT-)
unnamed: U6.1 (OUT1), U12.6 (ICC)
P_LIMIT: J19.1; also elsewhere on the board
R_LIMIT: J18.1; also elsewhere on the board
VAC1_SIG: R30.2, U11.7 (OUT2); also elsewhere on the board
VAC2_SIG: R22.2, U6.7 (OUT2); also elsewhere on the board
X_LIMIT: J60.1; also elsewhere on the board
Y_LIMIT: J61.1; also elsewhere on the board
Z_LIMIT: J62.1; also elsewhere on the board

Notes on the sheet:
Limit Switches

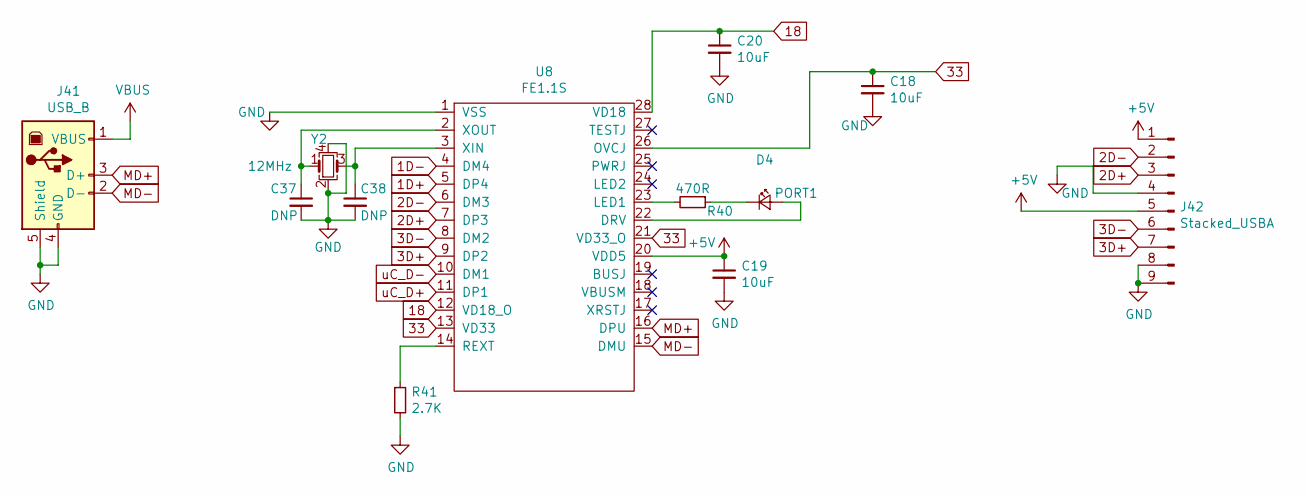
[picture p11: schematic usb.sch]

Parts:
C18, C19, C20: 10uF; C_0805_2012Metric_Pad1.15x1.40mm_HandSolder
C37, C38: DNP; C_0805_2012Metric_Pad1.15x1.40mm_HandSolder
D4: PORT1; LED_0805_2012Metric
J41: USB_B; USB_B_OST_USB-B1HSxx_Horizontal
J42: Stacked_USBA; USB_A_Wuerth_61400826021_Horizontal_Stacked
R40: 470R; R_0805_2012Metric_Pad1.15x1.40mm_HandSolder
R41: 2.7K; R_0805_2012Metric_Pad1.15x1.40mm_HandSolder
U8: FE1.1S; SSOP-28_3.9x9.9mm_P0.635mm
Y2: 12MHz; Crystal_SMD_3225-4Pin_3.2x2.5mm

Connections:
1D+: U8.5 (DP4)
1D-: U8.4 (DM4)
2D+: J42.3, U8.7 (DP3)
2D-: J42.2, U8.6 (DM3)
3D+: J42.7, U8.9 (DP2)
3D-: J42.6, U8.8 (DM2)
18: C20.1, U8.12 (VD18_O), U8.28 (VD18)
33: C18.1, U8.13 (VD33), U8.21 (VD33_O), U8.26 (OVCJ)
+5V: C19.1, J42.1, J42.5, U8.20 (VDD5); also elsewhere on the board
GND: C18.2, C19.2, C20.2, C37.2, C38.2, J41.4 (GND), J41.5 (Shield), J42.4, J42.8, J42.9, R41.2, U8.1 (VSS), Y2.2, Y2.4; also elsewhere on the board
MD+: J41.3 (D+), U8.16 (DPU)
MD-: J41.2 (D-), U8.15 (DMU)
unnamed: C37.1, U8.2 (XOUT), Y2.1
unnamed: C38.1, U8.3 (XIN), Y2.3
unnamed: D4.1 (K), R40.1
unnamed: D4.2 (A), U8.22 (DRV)
unnamed: R40.2, U8.23 (LED1)
unnamed: R41.1, U8.14 (REXT)
VBUS: J41.1 (VBUS)
uC_D+: U8.11 (DP1); also elsewhere on the board
uC_D-: U8.10 (DM1); also elsewhere on the board

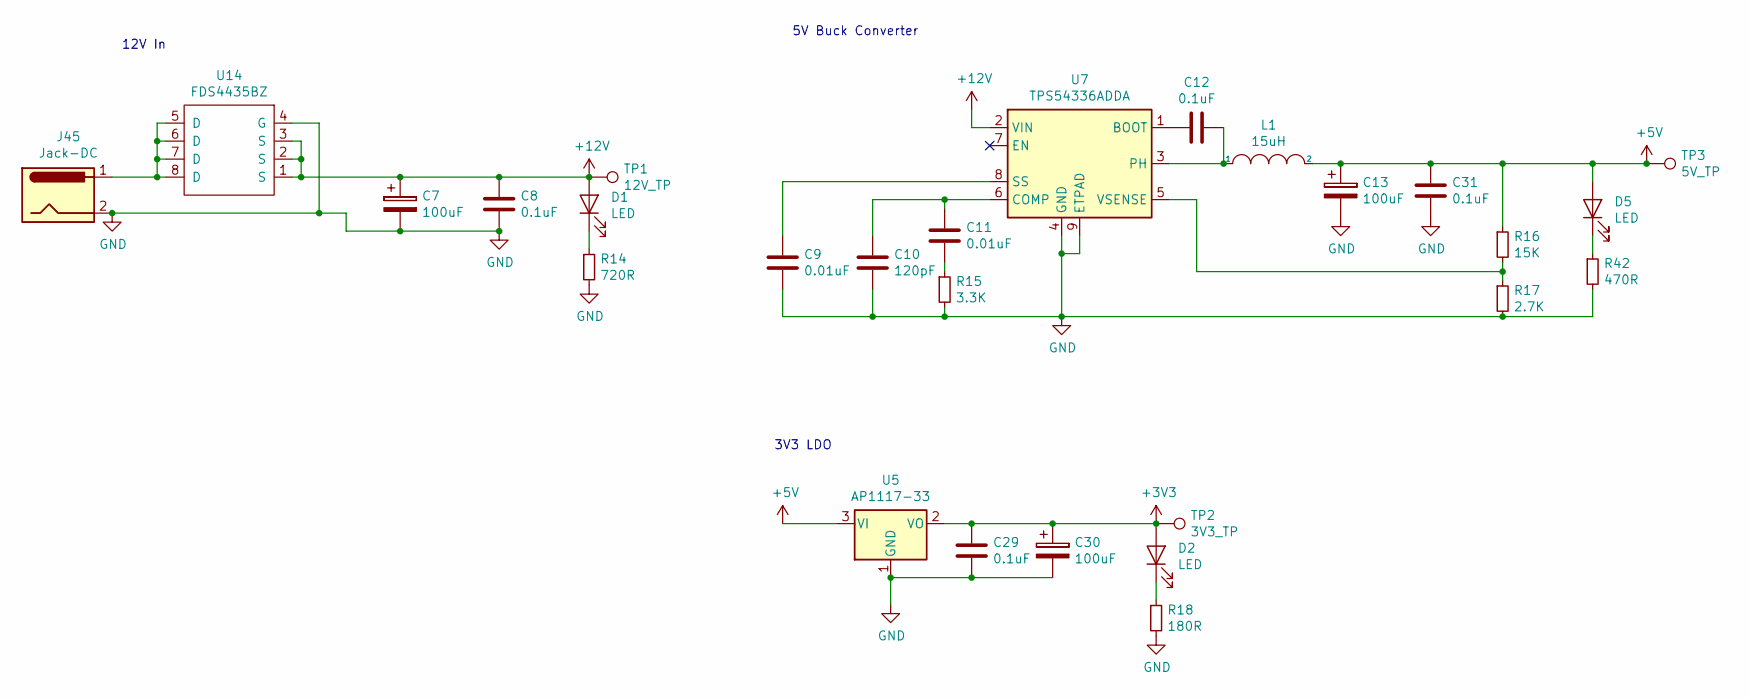
[picture p12: schematic power.sch]

Parts:
C7, C13, C30: 100uF; CP_Elec_6.3x7.7
C8, C12, C29, C31: 0.1uF; C_0805_2012Metric_Pad1.15x1.40mm_HandSolder
C9, C11: 0.01uF; C_0805_2012Metric_Pad1.15x1.40mm_HandSolder
C10: 120pF; C_0805_2012Metric_Pad1.15x1.40mm_HandSolder
D1, D2, D5: LED; LED_0805_2012Metric
J45: Jack-DC; BarrelJack_Horizontal
L1: 15uH; L_Bourns_SRR1260
R14: 720R; R_0805_2012Metric_Pad1.15x1.40mm_HandSolder
R15: 3.3K; R_0805_2012Metric_Pad1.15x1.40mm_HandSolder
R16: 15K; R_0805_2012Metric_Pad1.15x1.40mm_HandSolder
R17: 2.7K; R_0805_2012Metric_Pad1.15x1.40mm_HandSolder
R18: 180R; R_0805_2012Metric_Pad1.15x1.40mm_HandSolder
R42: 470R; R_0805_2012Metric_Pad1.15x1.40mm_HandSolder
TP1: 12V_TP; TestPoint_THTPad_1.0x1.0mm_Drill0.5mm
TP2: 3V3_TP; TestPoint_THTPad_1.0x1.0mm_Drill0.5mm
TP3: 5V_TP; TestPoint_THTPad_1.0x1.0mm_Drill0.5mm
U5: AP1117-33; SOT-223-3_TabPin2
U7: TPS54336ADDA; TI_SO-PowerPAD-8_ThermalVias
U14: FDS4435BZ; SO-8_3.9x4.9mm_P1.27mm

Connections:
+5V: C13.1, C31.1, D5.2 (A), L1.2, R16.1, TP3.1, U5.3 (VI); also elsewhere on the board
+12V: C7.1, C8.1, D1.2 (A), TP1.1, U7.2 (VIN), U14.1 (S), U14.2 (S), U14.3 (S); also elsewhere on the board
GND: C7.2, C8.2, C9.1, C10.1, C13.2, C29.2, C30.2, C31.2, J45.2, R14.2, R15.2, R17.2, R18.2, R42.2, U5.1 (GND), U7.4 (GND), U7.9 (ETPAD), U14.4 (G); also elsewhere on the board
unnamed: C9.2, U7.8 (SS)
unnamed: C10.2, C11.2, U7.6 (COMP)
unnamed: C11.1, R15.1
unnamed: C12.1, L1.1, U7.3 (PH)
unnamed: C12.2, U7.1 (BOOT)
unnamed: D1.1 (K), R14.1
unnamed: D2.1 (K), R18.1
unnamed: D5.1 (K), R42.1
unnamed: J45.1, U14.5 (D), U14.6 (D), U14.7 (D), U14.8 (D)
unnamed: R16.2, R17.1, U7.5 (VSENSE)

Notes on the sheet:
5V Buck Converter
3V3 LDO
12V In

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
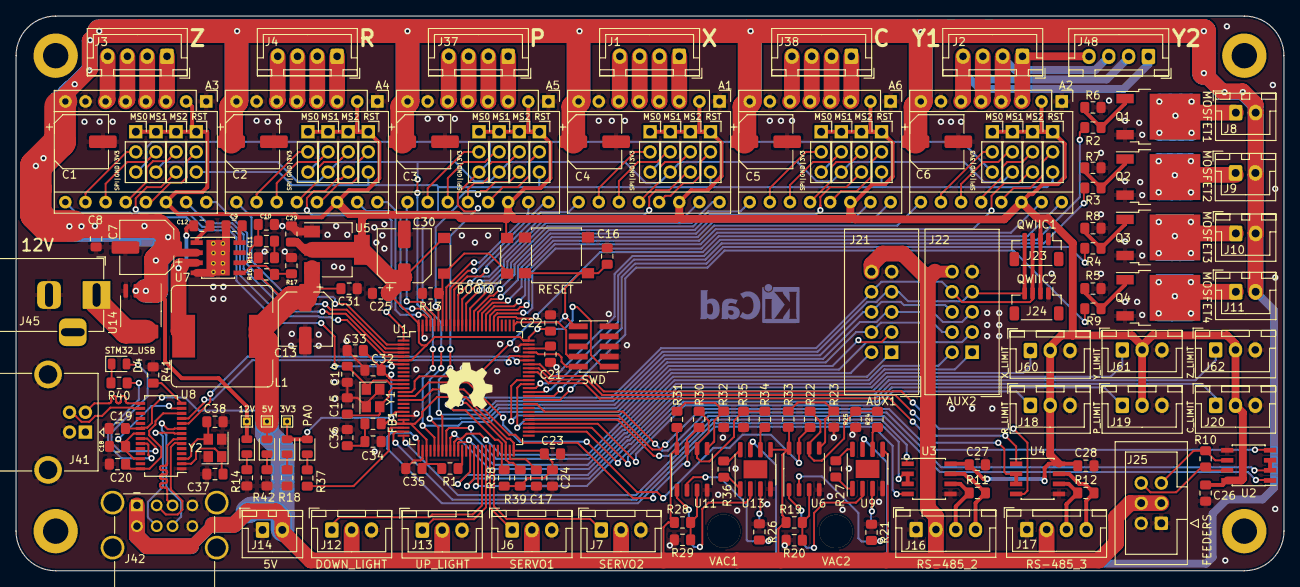
[picture p13: board mobo.kicad_pcb from above]

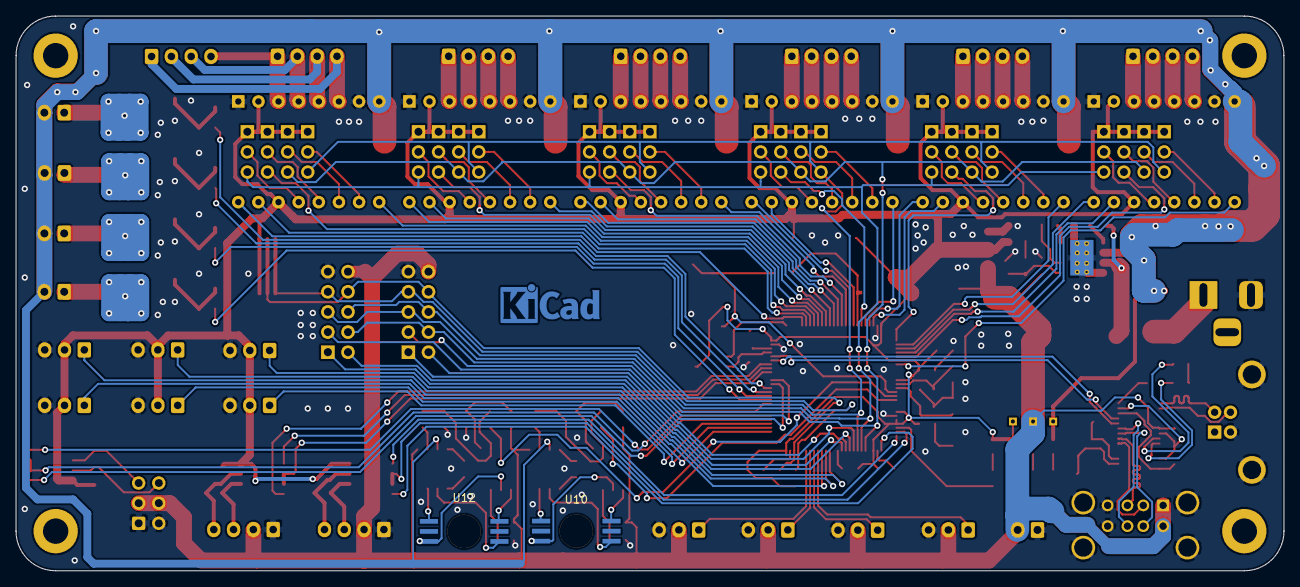
[picture p14: board mobo.kicad_pcb from below]

Board: 2 copper layers, 160.0 x 70.0 mm, 179 parts (2 on the bottom side), 184 nets.
