icegoaliepaul/index/(commit log)

2020-11-08 Add belt stand-offs to y gantry so that belt runs parallel. Separate y-gantry-belt-standoff.stl can be printed and glued to the old x-gantry parts to "upgrade" them
    [y-gantry-belt-standoff.stl, y-gantry-left.stl, y-gantry-right.stl]
2020-11-13 Add belt standoffs to x-gantry-back
    [x-gantry-back.stl]
2020-11-13 Add holder for down facing camera
    [Camera Holder.f3d, Camera Holder.step, Camera Holder.stl]
2020-11-16 add an actuator for the x limit switch to be bolted to the same mounting holes as the belt clamps. Gives extra clearance for the z-gantry
    [x-limit-switch-actuator.f3d, x-limit-switch-actuator.step, x-limit-switch-actuator.stl]
2020-12-14 Make z-gantrys longer and add flag to the left gantry for centre homing. Modify motion.cpp so that homing will move away from the endstop until no longer triggered.
    [Configuration.h, z-gantry-stepper-left.f3d, z-gantry-stepper-left.step, z-gantry-stepper-left.stl, z-gantry-stepper-right.f3d, z-gantry-stepper-right.step, z-gantry-stepper-right.stl]
